bass0324/smart_touch_display/Smart_Display_Prototype.JPG

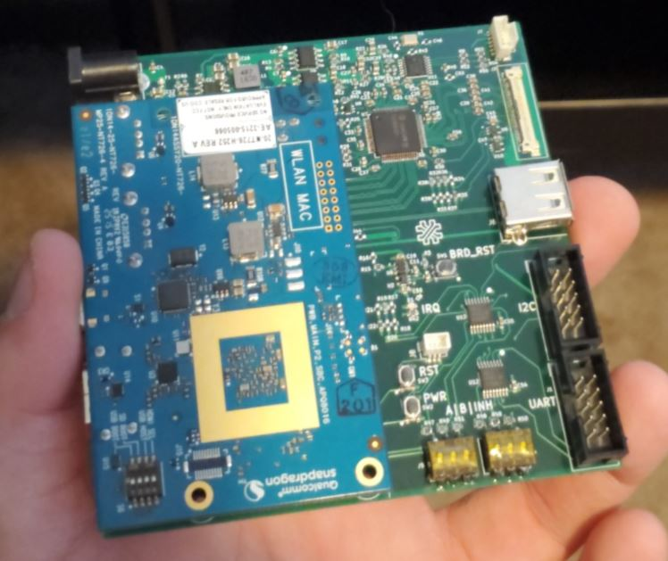
Smart_Display_Prototype.JPG
