bass0324/smart_touch_display/IMG_20190621_161926_01_01.jpg

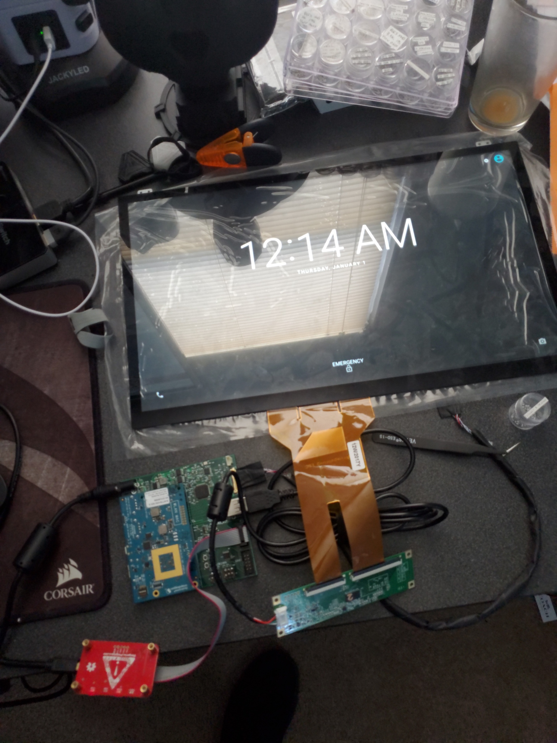
IMG_20190621_161926_01_01.jpg
