bass0324/smart_touch_display/Board Renders/Bad Phase/bottom.png

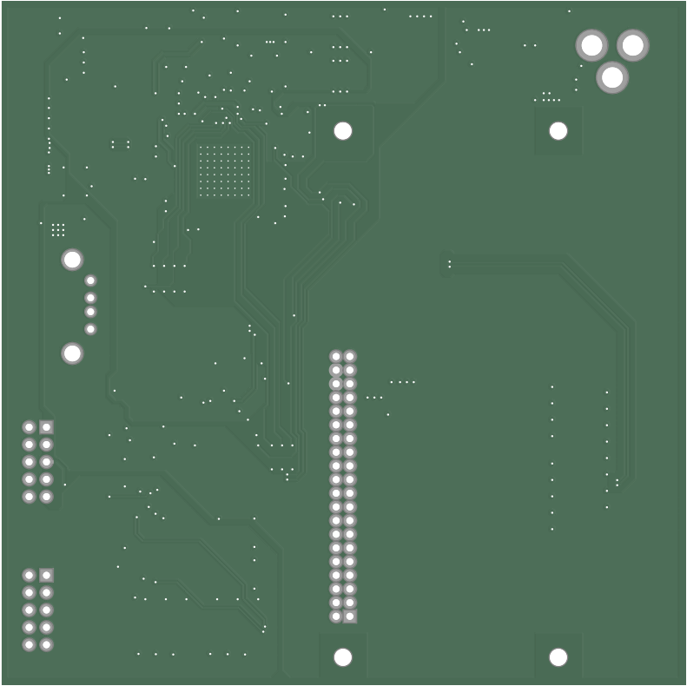
Board Renders/Bad Phase/bottom.png
