bass0324/smart_touch_display/Board Renders/Bad Phase/bottom_copper.png

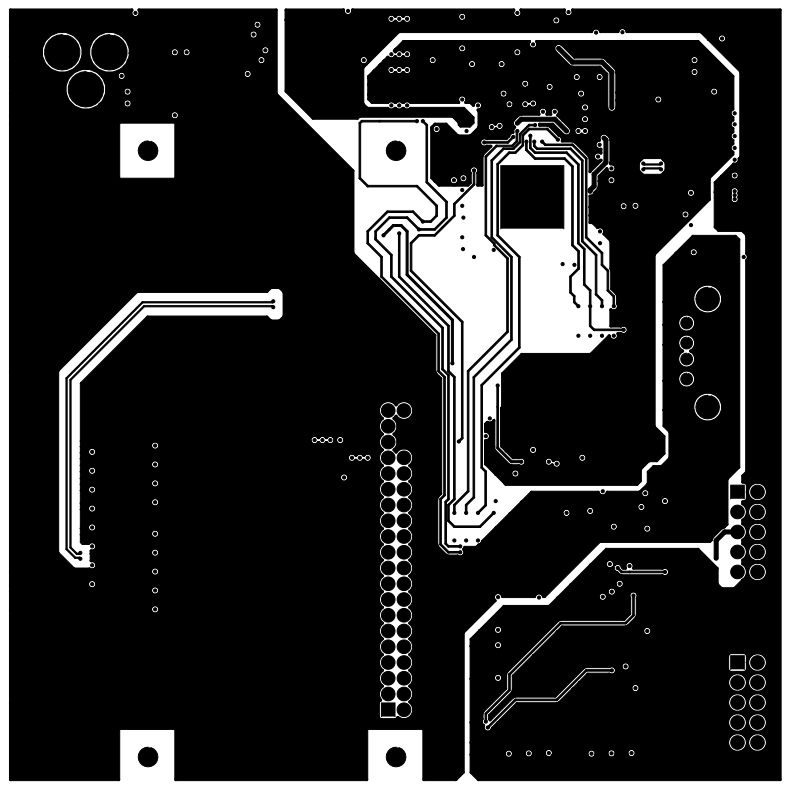
Board Renders/Bad Phase/bottom_copper.png
