bass0324/smart_touch_display/Board Renders/Bad Phase/mill.png

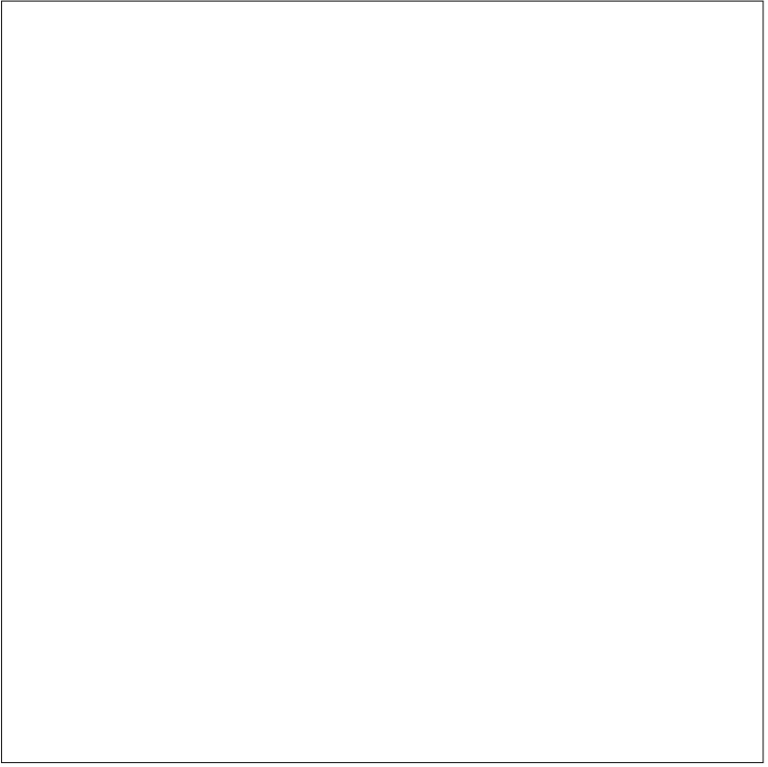
Board Renders/Bad Phase/mill.png
