bass0324/smart_touch_display/Board Renders/Bad Phase/top_silkscreen.png

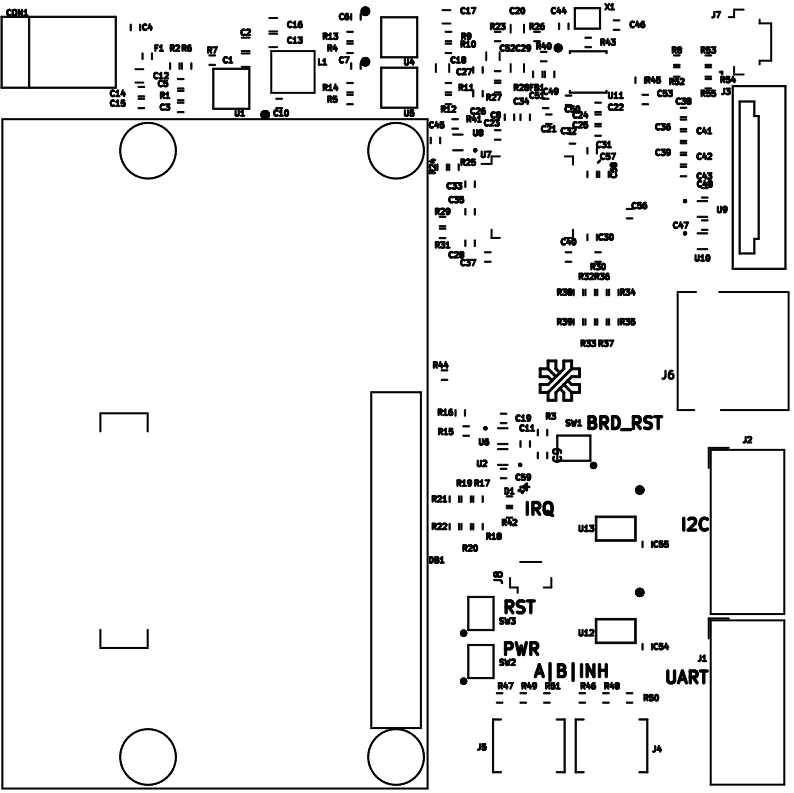
Board Renders/Bad Phase/top_silkscreen.png
