bass0324/smart_touch_display/IMG_20190530_161939_01_01.jpg

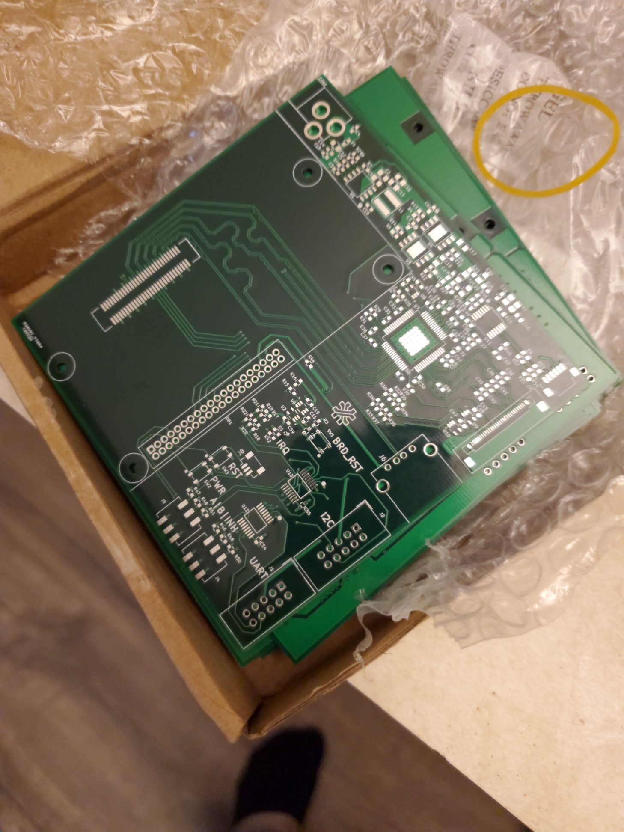
IMG_20190530_161939_01_01.jpg
