bass0324/smart_touch_display/IMG_20190613_172316_01_02.jpg

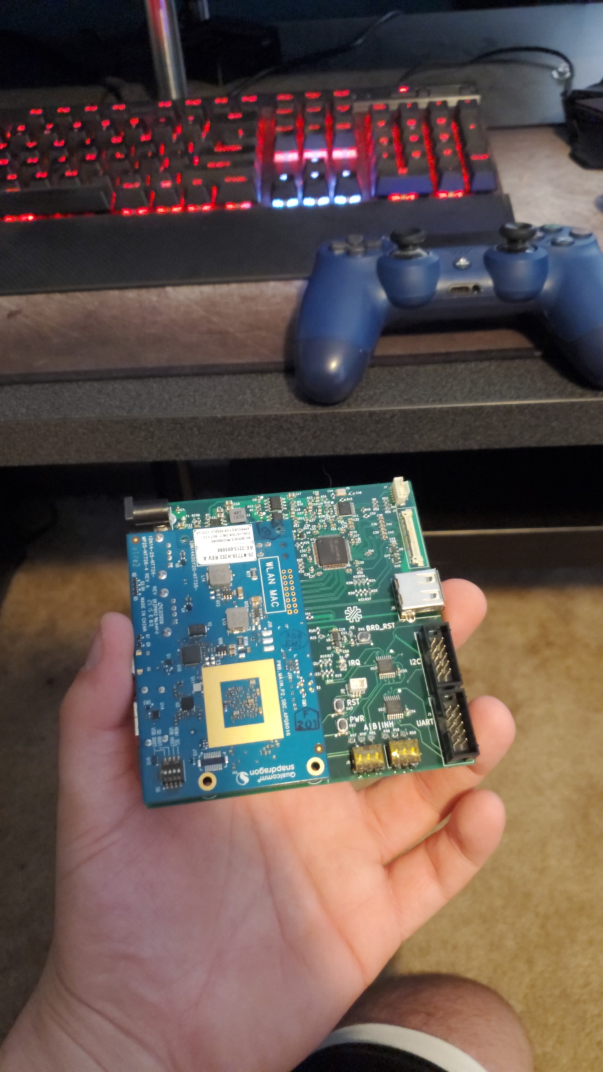
IMG_20190613_172316_01_02.jpg
