bass0324/smart_touch_display/Smart_Display_Block_Diagram.JPG

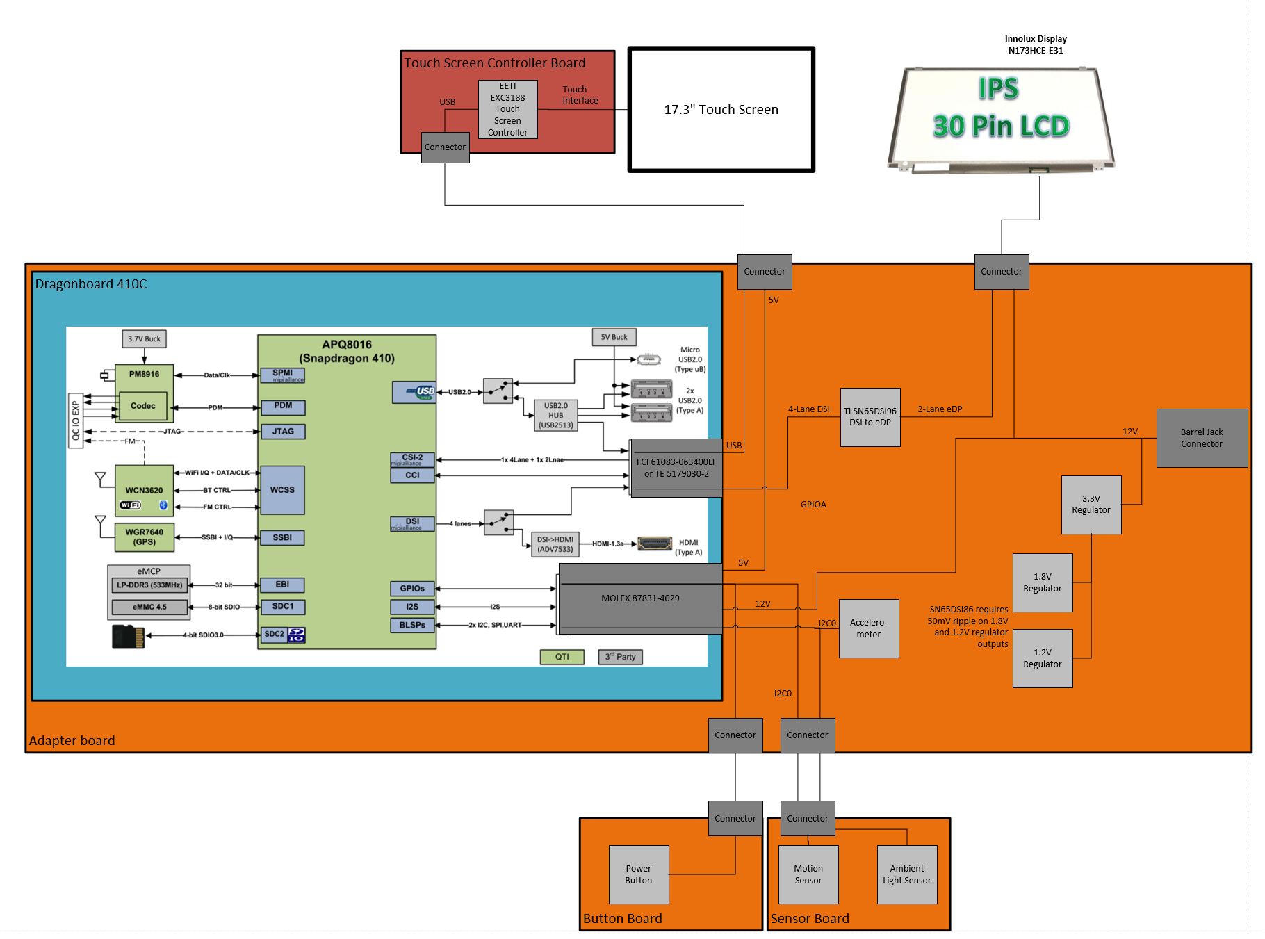
Smart_Display_Block_Diagram.JPG
