bass0324/smart_touch_display/Slate_Logic_Board.csv

Source: | C:/Users/basis/Dropbox/Projects/KiCAD/Slate_Logic_Board/Slate_Logic_Board.sch
Date: | 5/20/2019 9:18:26 PM
Tool: | Eeschema 4.0.7
Component Count: | 144
Ref | Value | Footprint | Datasheet | Manufacturer | Vendor
C1 | 10uF,0805,25V | Capacitors_SMD:C_0805
C2 | 10uF,0805,25V | Capacitors_SMD:C_0805
C3 | 0.1uF,0603,25V | bass:SMD_0603
C4 | 0.1uF,0603,25V | bass:SMD_0603
C5 | 3.3nF,0603,25V | bass:SMD_0603
C6 | 1uF,0603,25V | bass:SMD_0603
C7 | 1uF,0603,25V | bass:SMD_0603
C8 | 0.1uF,0603,25V | bass:SMD_0603
C9 | 0.1uF,0603,25V | bass:SMD_0603
C10 | 10nF,0603,25V | bass:SMD_0603
C11 | 220pF,0603,25V | bass:SMD_0603
C12 | 10uF,0805,25V | Capacitors_SMD:C_0805
C13 | 22uF,0805,25V | Capacitors_SMD:C_0805
C14 | 0.1uF,0603,25V | bass:SMD_0603
C15 | 0.1uF,0603,25V | bass:SMD_0603
C16 | 22uF,0805,25V | Capacitors_SMD:C_0805
C17 | 10uF,0805,25V | Capacitors_SMD:C_0805
C18 | 10uF,0805,25V | Capacitors_SMD:C_0805
C19 | 0.1uF,0603,25V | bass:SMD_0603
C20 | 10uF,0805,25V | Capacitors_SMD:C_0805
C21 | 0.1uF,0603,25V | bass:SMD_0603
C22 | 1uF,0603,25V | bass:SMD_0603
C23 | 0.1uF,0603,25V | bass:SMD_0603
C24 | 0.1uF,0603,25V | bass:SMD_0603
C25 | 0.1uF,0603,25V | bass:SMD_0603
C26 | 0.1uF,0603,25V | bass:SMD_0603
C27 | 0.1uF,0603,25V | bass:SMD_0603
C28 | 1uF,0603,25V | bass:SMD_0603
C29 | 10uF,0805,25V | Capacitors_SMD:C_0805
C30 | 0.1uF,0603,25V | bass:SMD_0603
C31 | 1uF,0603,25V | bass:SMD_0603
C32 | 0.1uF,0603,25V | bass:SMD_0603
C33 | 0.1uF,0603,25V | bass:SMD_0603
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
U8 | SN74LVC1G07DCK | bass:SOT23-5_65mm
U9 | SN74AUP1T08DCK | bass:SOT23-5_65mm
U10 | SN74AUP1T08DCK | bass:SOT23-5_65mm
U11 | CDCEL913PW | bass:TSSOP-14_4.4x5mm_Pitch0.65mm
U12 | SN74LV4052APW | bass:TSSOP16-0.65mm
U13 | SN74LV4052APW | bass:TSSOP16-0.65mm
X1 | CRYSTAL_27MHz | bass:4pin-SMD-OSC
