bass0324/smart_touch_display/Slate_Logic_Board.xlsx

Source: | C:/Users/basis/Dropbox/Projects/KiCAD/Slate_Logic_Board/Slate_Logic_Board.sch
Date: | 2019-05-20 21:18
Tool: | Eeschema 4.0.7
Component Count: | 144
Ref | Value | Footprint | Datasheet | Manufacturer | Vendor | Ordered? | Alternative | Placed?
R15 | 0,0402,1% | bass:SMD_0603 |  |  |  | In Stock |  | Y
R22 | 0,0402,1% | bass:SMD_0603 |  |  |  | In Stock |  | y
R23 | 0,0402,1% | bass:SMD_0603 |  |  |  | In Stock |  | y
R26 | 0,0402,1% | bass:SMD_0603 |  |  |  | In Stock |  | y
R27 | 0,0402,1% | bass:SMD_0603 |  |  |  | In Stock |  | y
R28 | 0,0402,1% | bass:SMD_0603 |  |  |  | In Stock |  | y
R29 | 0,0402,1% | bass:SMD_0603 |  |  |  | In Stock |  | y
R30 | 0,0402,1% | bass:SMD_0603 |  |  |  | In Stock |  | y
R31 | 0,0402,1% | bass:SMD_0603 |  |  |  | In Stock |  | y
R35 | 0,0402,1% | bass:SMD_0603 |  |  |  | In Stock |  | y, 4.7k
R4 | 0,0402,1% | bass:SMD_0603 |  |  |  | In Stock |  | y
R5 | 0,0402,1% | bass:SMD_0603 |  |  |  | In Stock |  | y
R52 | 0,0402,1% | bass:SMD_0603 |  |  |  | In Stock |  | y
R53 | 0,0402,1% | bass:SMD_0603 |  |  |  | In Stock |  | y
R54 | 0,0402,1% | bass:SMD_0603 |  |  |  | In Stock |  | y
R8 | 0,0402,1% | bass:SMD_0603 |  |  |  | In Stock |  | y
R18 | 0,0402,1%,DNI | bass:SMD_0603 |  |  |  | In Stock |  | DNI
R20 | 0,0402,1%,DNI | bass:SMD_0603 |  |  |  | In Stock |  | DNI
R25 | 0,0402,1%,DNI | bass:SMD_0603 |  |  |  | In Stock |  | DNI
R33 | 0,0402,1%,DNI | bass:SMD_0603 |  |  |  | In Stock |  | DNI
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
C18 | 10uF,0805,25V | Capacitors_SMD:C_0805 |  |  |  | Mouser |  | y
C2 | 10uF,0805,25V | Capacitors_SMD:C_0805 |  |  |  | Mouser |  | y
C20 | 10uF,0805,25V | Capacitors_SMD:C_0805 |  |  |  | Mouser |  | y
C29 | 10uF,0805,25V | Capacitors_SMD:C_0805 |  |  |  | Mouser |  | y
R9 | 12.4k,0402,1% | bass:SMD_0603 |  |  |  | Mouser |  | y
R45 | 18,0402,1% | bass:SMD_0603 |  |  |  | Mouser |  | y
R41 | 1k,0402,1% | bass:SMD_0603 |  |  |  | In Stock |  | y
R43 | 1M,0402,1%,DNI | bass:SMD_0603 |  |  |  | In Stock |  | DNI
C22 | 1uF,0603,25V | bass:SMD_0603 |  |  |  | In Stock |  | y
C28 | 1uF,0603,25V | bass:SMD_0603 |  |  |  | In Stock |  | y
C31 | 1uF,0603,25V | bass:SMD_0603 |  |  |  | In Stock |  | y
C6 | 1uF,0603,25V | bass:SMD_0603 |  |  |  | In Stock |  | y
C7 | 1uF,0603,25V | bass:SMD_0603 |  |  |  | In Stock |  | y
C11 | 220pF,0603,25V | bass:SMD_0603 |  |  |  | Mouser |  | y
C13 | 22uF,0805,25V | Capacitors_SMD:C_0805 |  |  |  | Mouser |  | y
C16 | 22uF,0805,25V | Capacitors_SMD:C_0805 |  |  |  | Mouser |  | y
C52 | 22uF,0805,25V | Capacitors_SMD:C_0805 |  |  |  | Mouser |  | y
R7 | 26.1k,0402,1% | bass:SMD_0603 |  |  |  | Mouser |  | y
C5 | 3.3nF,0603,25V | bass:SMD_0603 |  |  |  | In Stock |  | y
R42 | 330,0402,1% | bass:SMD_0603 |  |  |  | In Stock |  | y
R19 | 4.75k,0402,1% | bass:SMD_0603 |  |  |  | In Stock |  | y
R24 | 4.75k,0402,1% | bass:SMD_0603 |  |  |  | In Stock |  | y
R32 | 4.75k,0402,1% | bass:SMD_0603 |  |  |  | In Stock |  | y
R36 | 4.75k,0402,1% | bass:SMD_0603 |  |  |  | In Stock |  | y
R38 | 4.75k,0402,1% | bass:SMD_0603 |  |  |  | In Stock |  | y
R17 | 4.75k,0402,1%,DNI | bass:SMD_0603 |  |  |  | In Stock |  | DNI
R21 | 4.75k,0402,1%,DNI | bass:SMD_0603 |  |  |  | In Stock |  | DNI
R34 | 4.75k,0402,1%,DNI | bass:SMD_0603 |  |  |  | In Stock |  | DNI
L1 | 4.7uH | bass:L_Bourns_SRP5030CA | Bourns | SRP5030CA-4R7M |  | Mouser | SRP5030CA-2R2M | y
R11 | 4.99k,0402,1% | bass:SMD_0603 |  |  |  | Mouser |  | y
U1 | AP3512E | bass:SOIC-8-N | Diodes | AP3512EMTR-G1 |  | Digikey |  | y
U4 | AP7165_SO8 | bass:SOIC-8-N-AP7165 | Diodes | AP7165-SPG-13 |  | Mouser |  | y
U5 | AP7165_SO8 | bass:SOIC-8-N-AP7165 | Diodes | AP7165-SPG-13 |  | Mouser |  | y
CON1 | BARREL_JACK | bass:BARREL_JACK |  |  |  | In Stock
FB1 | BLM18EG221SN1D | bass:SMD_0603 | Murata | BLM18EG221SN1D |  | Mouser |  | y
SW1 | BUTTON_BASS | bass:CK_PTS810 | C&K | PTS810SJM250SMTR |  | Mouser |  | y
SW2 | BUTTON_BASS | bass:CK_PTS810 | C&K | PTS810SJM250SMTR |  | Mouser |  | y
SW3 | BUTTON_BASS | bass:CK_PTS810 | C&K | PTS810SJM250SMTR |  | Mouser |  | y
U11 | CDCEL913PW | bass:TSSOP-14_4.4x5mm_Pitch0.65mm | TI | CDCEL913PW |  | Sample |  | y
J8 | Conn_01x03 | Connectors_Molex:Molex_PicoClasp_501331-0307_1x03_P1.0mm_Vertical | Molex | 5013310307 |  | Mouser |  | y
J7 | Conn_01x06 | Connectors_Molex:Molex_PicoClasp_501331-0607_1x06_P1.0mm_Vertical | Molex | 5013310607 |  | Mouser |  | y
J3 | Conn_01x34 | bass:20455-030E | IPEX | 20455-030E |  | Ebay |  | y
J1 | CONN_02X05 | Connectors_IDC:IDC-Header_2x05_Pitch2.54mm_Straight | 3M | 30310-6002HB |  | Mouser
J2 | CONN_02X05 | Connectors_IDC:IDC-Header_2x05_Pitch2.54mm_Straight | 3M | 30310-6002HB |  | Mouser
X1 | CRYSTAL_27MHz | bass:4pin-SMD-OSC | Abracon | ABM8-27.000MHZ-10-1-U-T |  | Mouser |  | y
J4 | CT2193MST | bass:CT2193MST | CTS Electrocomponents | 219-3MST |  | Mouser |  | y
J5 | CT2193MST | bass:CT2193MST | CTS Electrocomponents | 219-3MST |  | Mouser |  | y
D1 | LED | bass:SMD_0603 |  |  |  | In Stock |  | y
U7 | SN65DSI86-Q1 | bass:HTQFP-64-1EP_10x10mm_Pitch0.5mm_ThermalPad_SN65DSIx6-Q1 | TI | SN65DSI86IPAPQ1 |  | Sample |  | y
U10 | SN74AUP1T08DCK | bass:SOT23-5_65mm | TI | SN74AUP1T08DCK |  | Sample |  | y
U2 | SN74AUP1T08DCK | bass:SOT23-5_65mm | TI | SN74AUP1T08DCK |  | Sample |  | y
U9 | SN74AUP1T08DCK | bass:SOT23-5_65mm | TI | SN74AUP1T08DCK |  | Sample |  | y
U12 | SN74LV4052APW | bass:TSSOP16-0.65mm | TI | SN74LV4052APW |  | Sample |  | y
U13 | SN74LV4052APW | bass:TSSOP16-0.65mm | TI | SN74LV4052APW |  | Sample |  | y
U8 | SN74LVC1G07DCK | bass:SOT23-5_65mm | TI | SN74LVC1G07DCK |  | Sample |  | y
U6 | TPS3808G18DBVT | bass:SOT23-6_65mm | TI | TPS3808G18DBVT |  | Sample |  | y
J6 | USB_A | Connectors:USB_A |  |  |  | In Stock
DB1 | Dragonboard | bass:96boards_baseboard | Moxel | 87831-4020 |  | Mouser
 |  |  | FCI | 61083-063400LF |  | Mouser |  | y
