bass0324/smart_touch_display/Board Renders/Bad Phase/bottom_soldermask.png

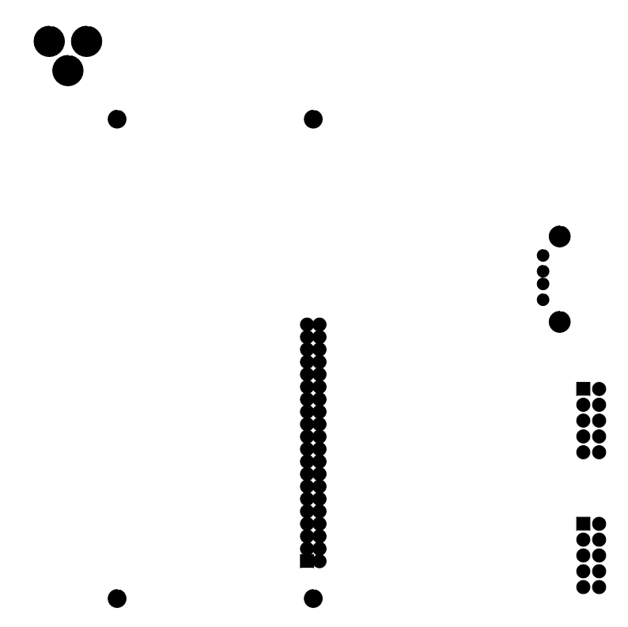
Board Renders/Bad Phase/bottom_soldermask.png
