bass0324/smart_touch_display/Board Renders/Bad Phase/top_soldermask.png

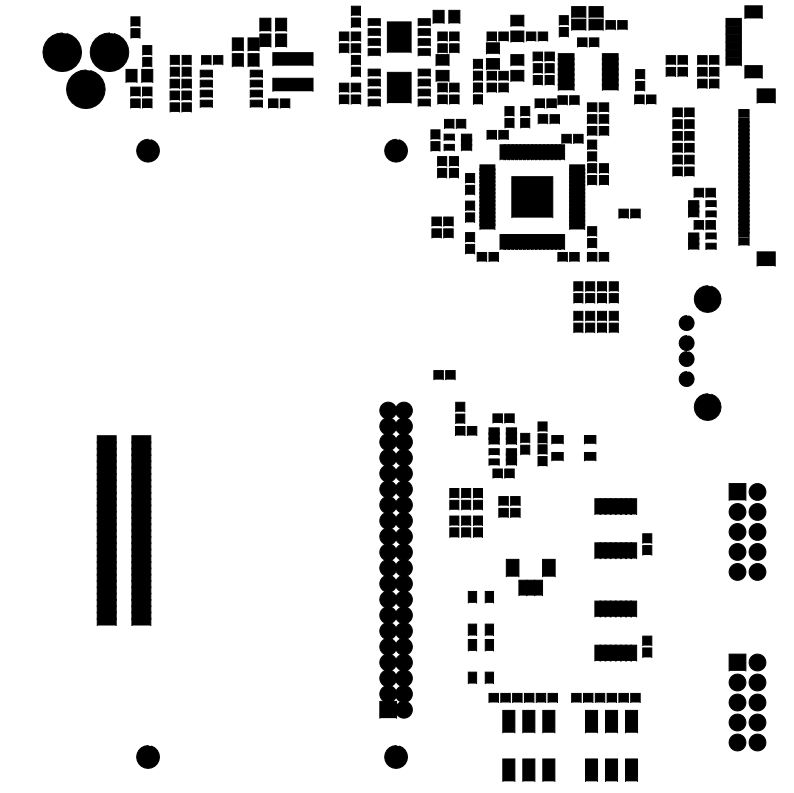
Board Renders/Bad Phase/top_soldermask.png
