bass0324/smart_touch_display/Slate_Logic_Board.kicad_pcb

## KiCad design Slate_Logic_Board.kicad_pcb (2019-06-22)

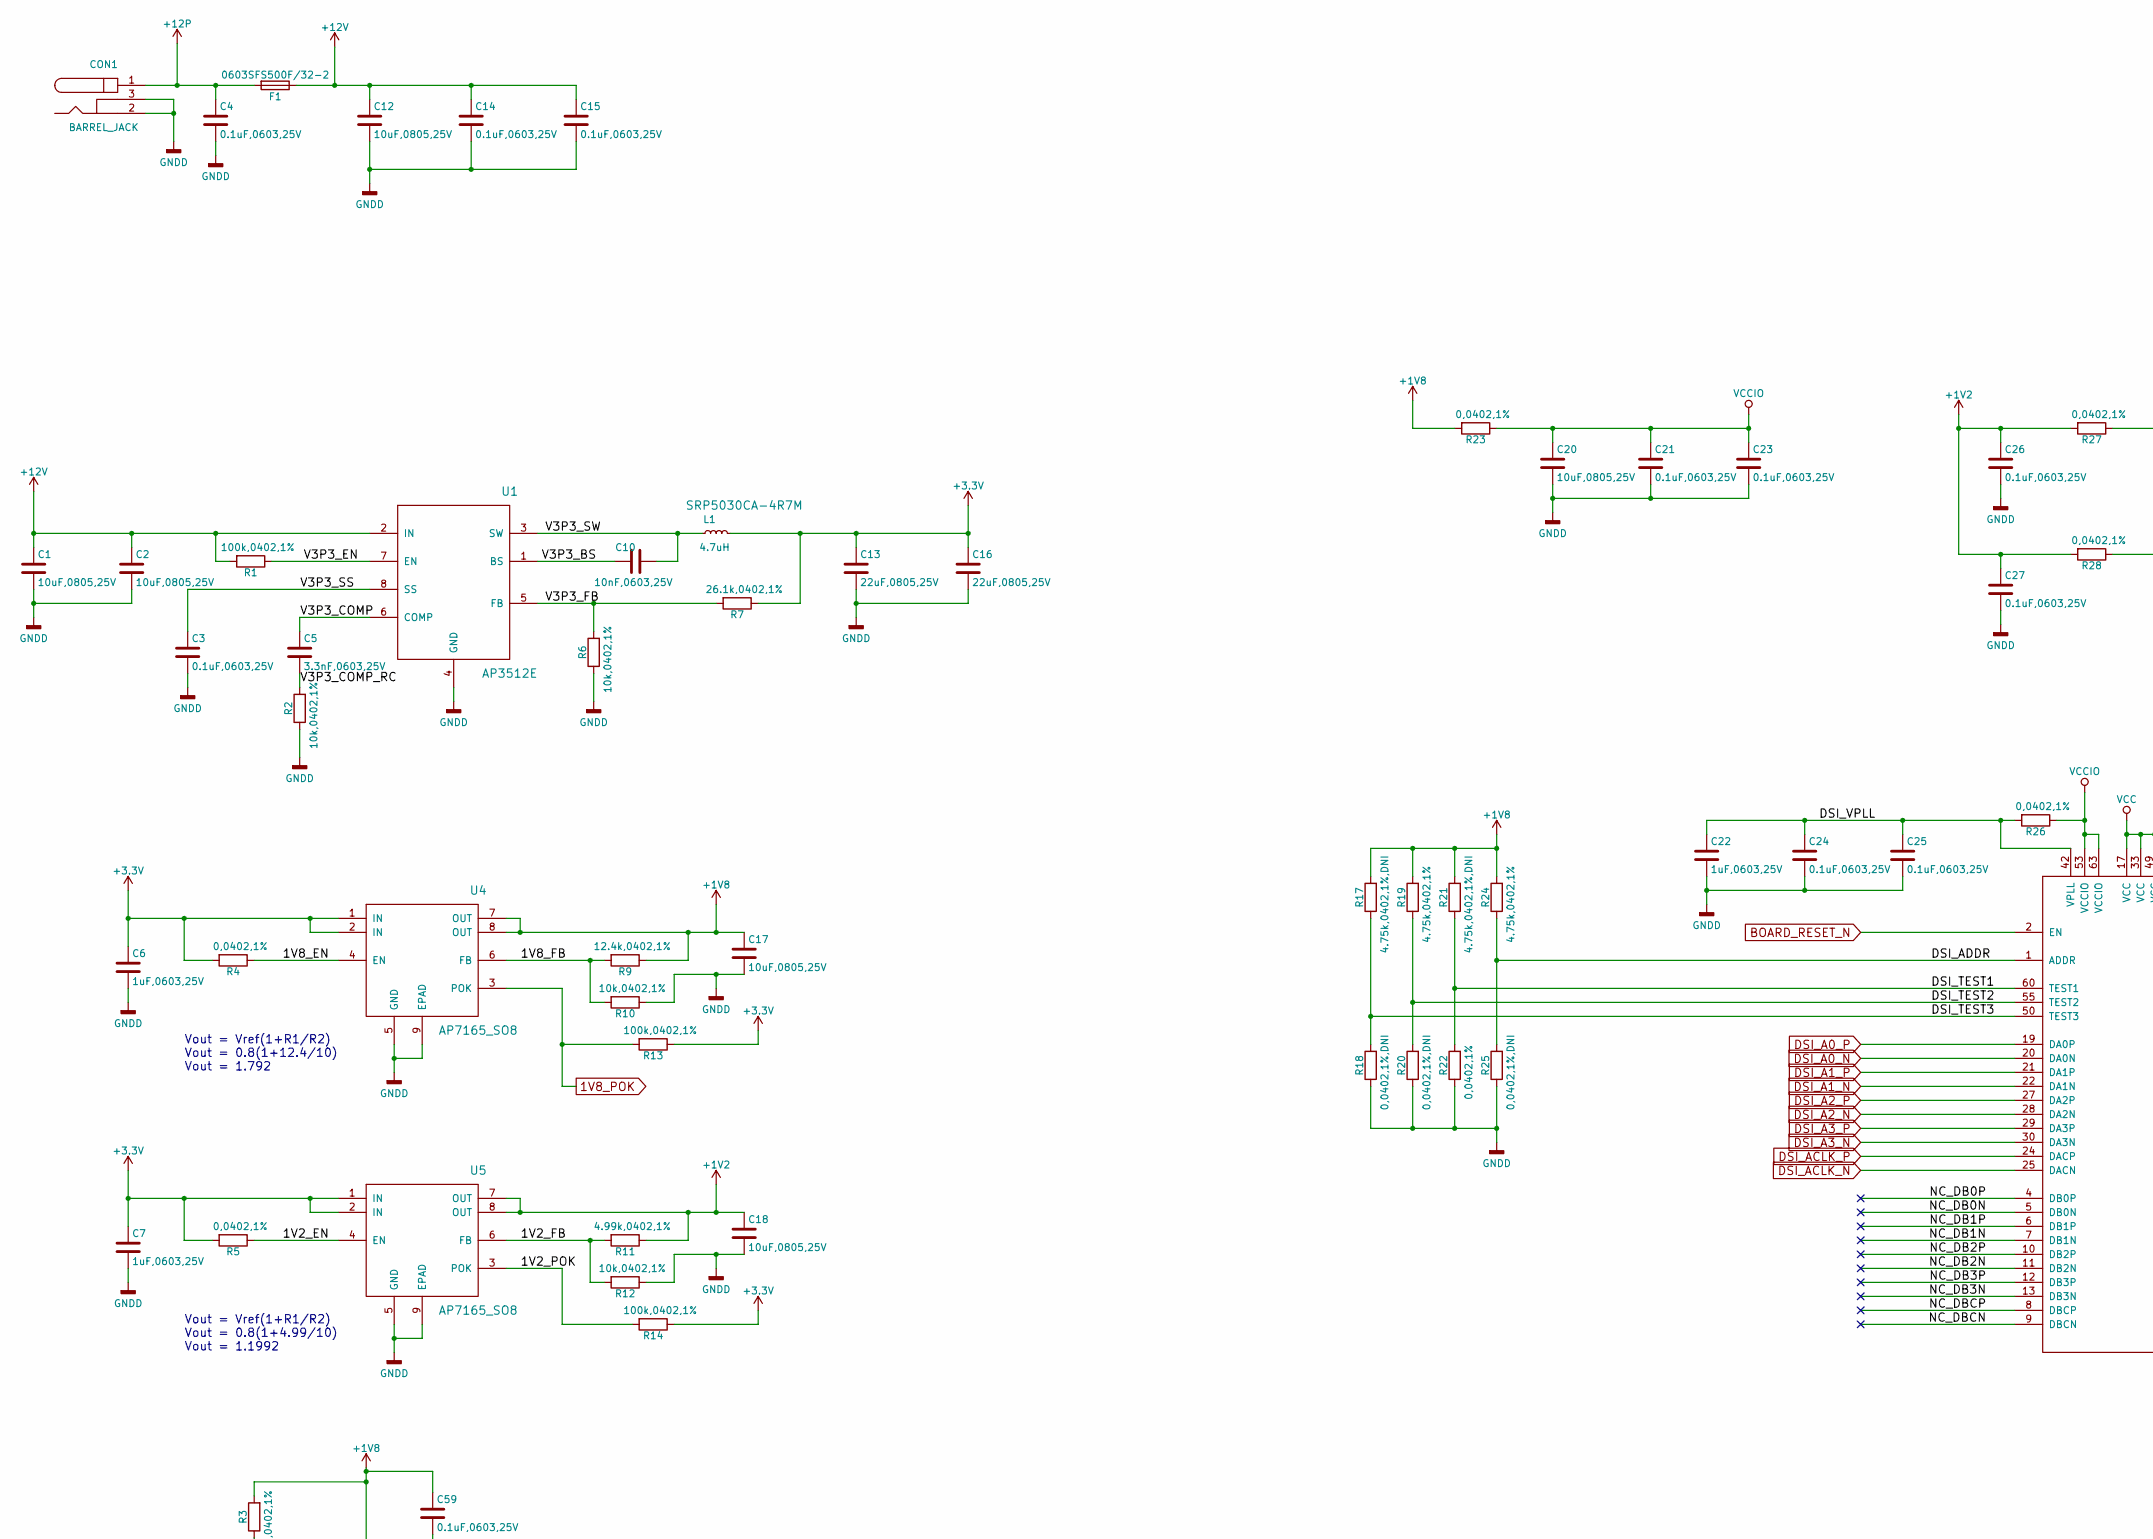
[picture p14: schematic Slate_Logic_Board.sch, TOC, part in row 1, column 1]

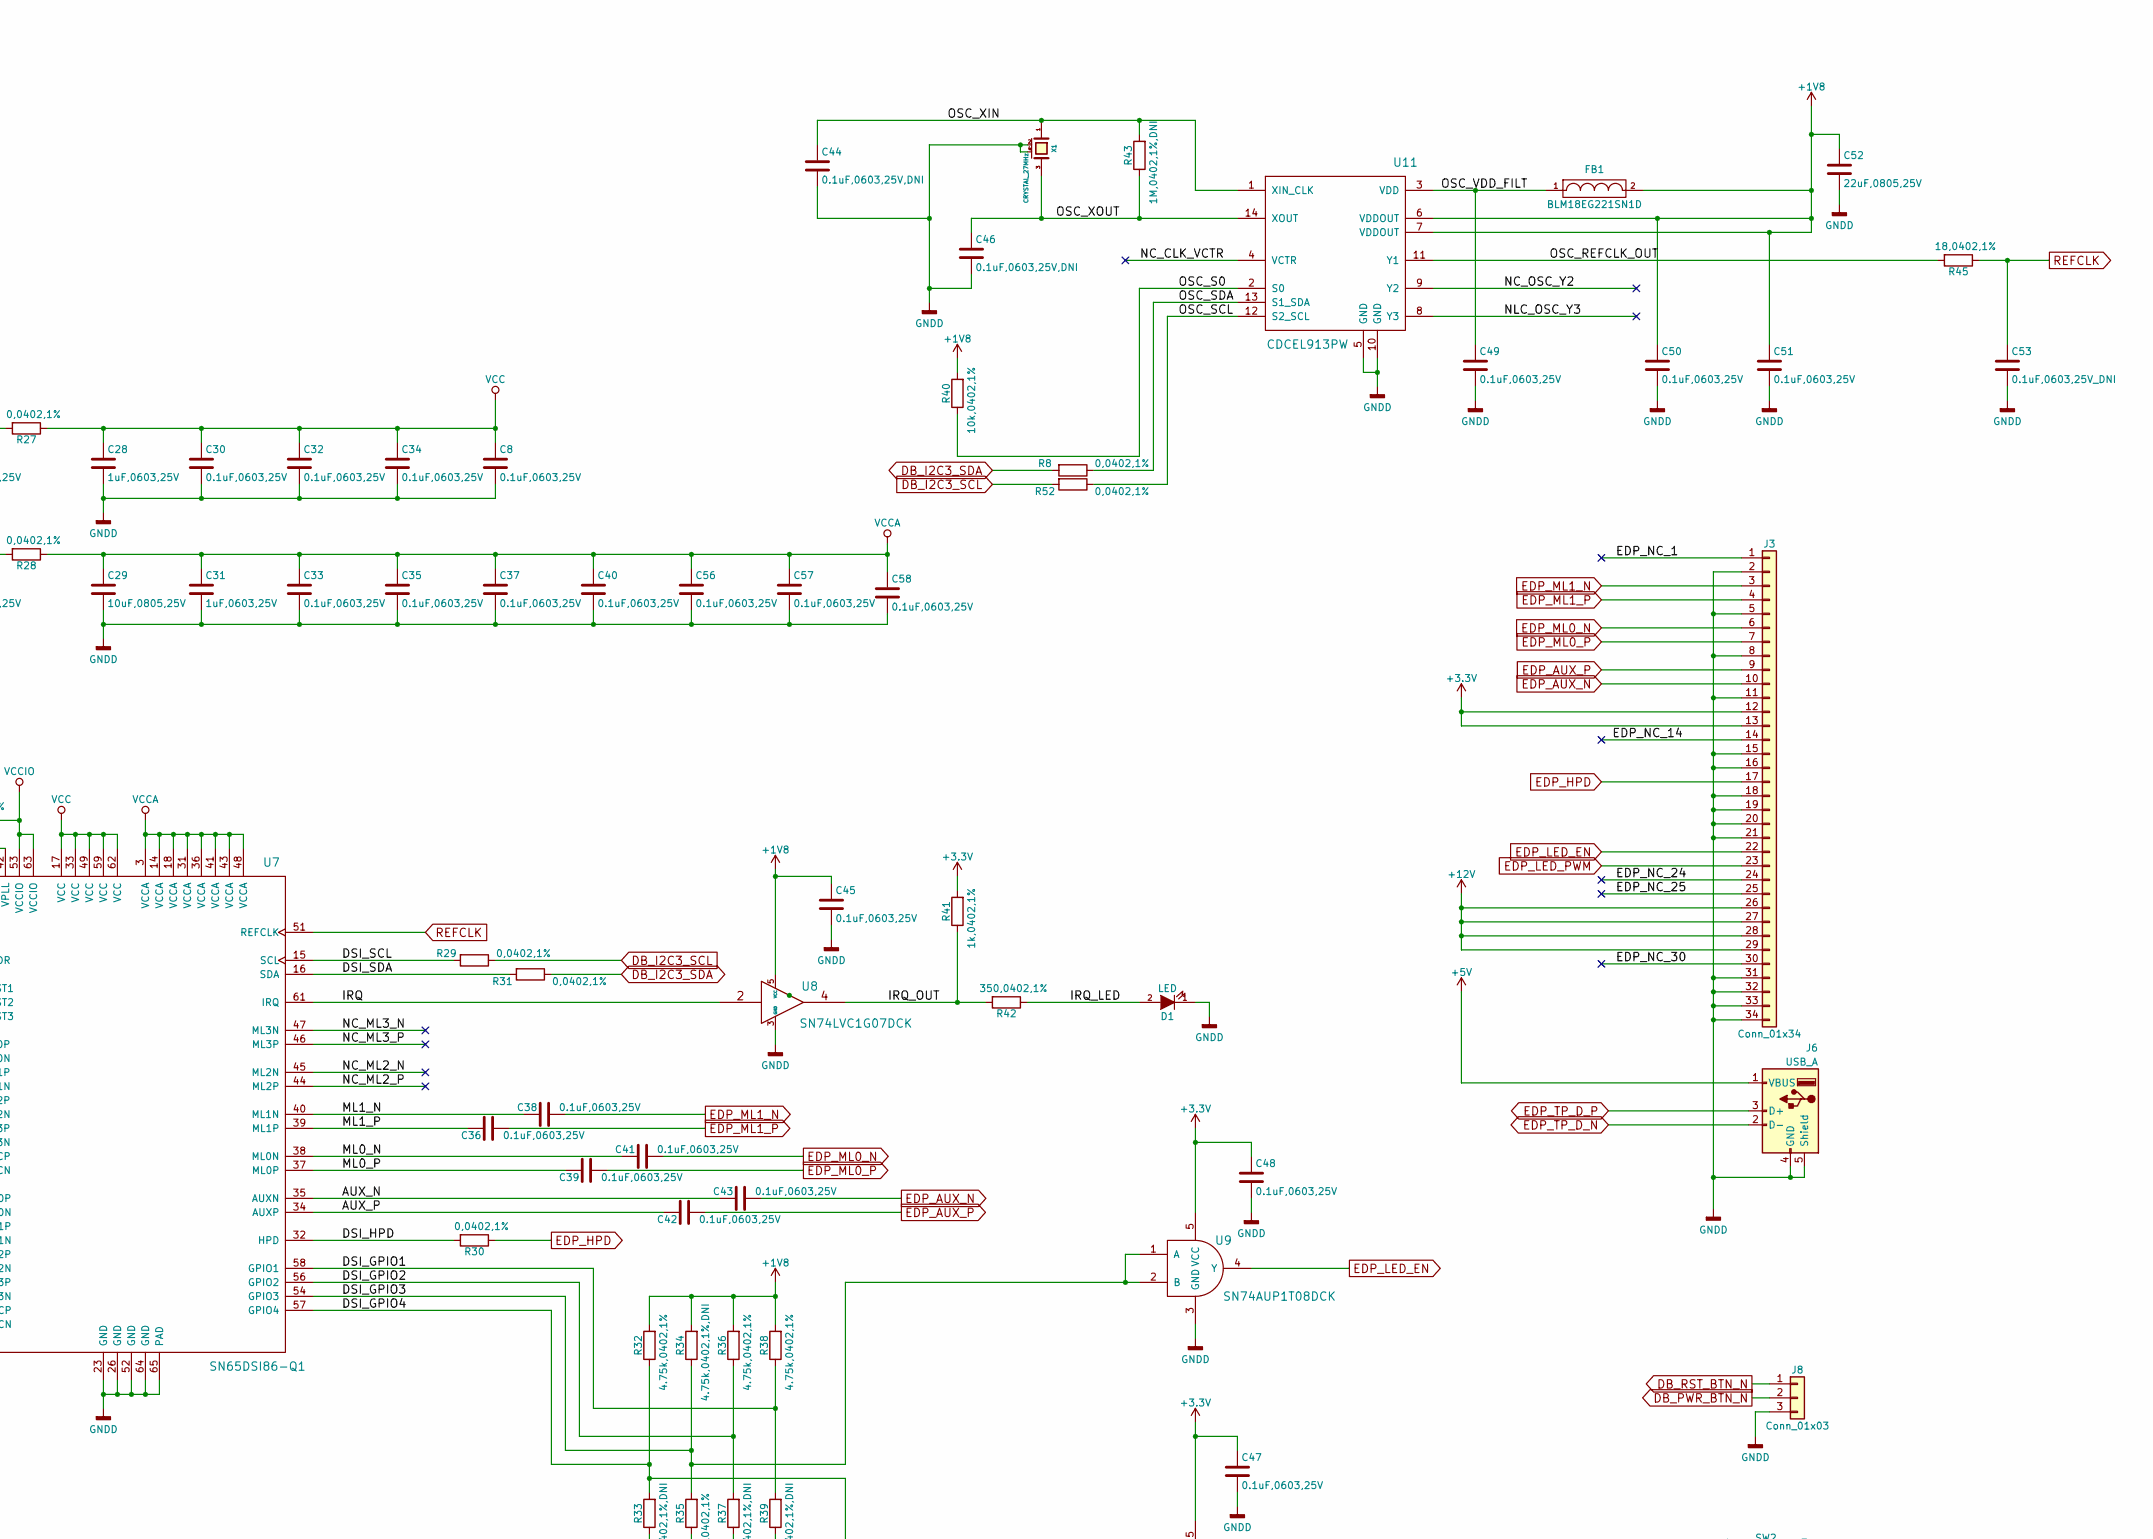
[picture p15: schematic Slate_Logic_Board.sch, TOC, part in row 1, column 2]

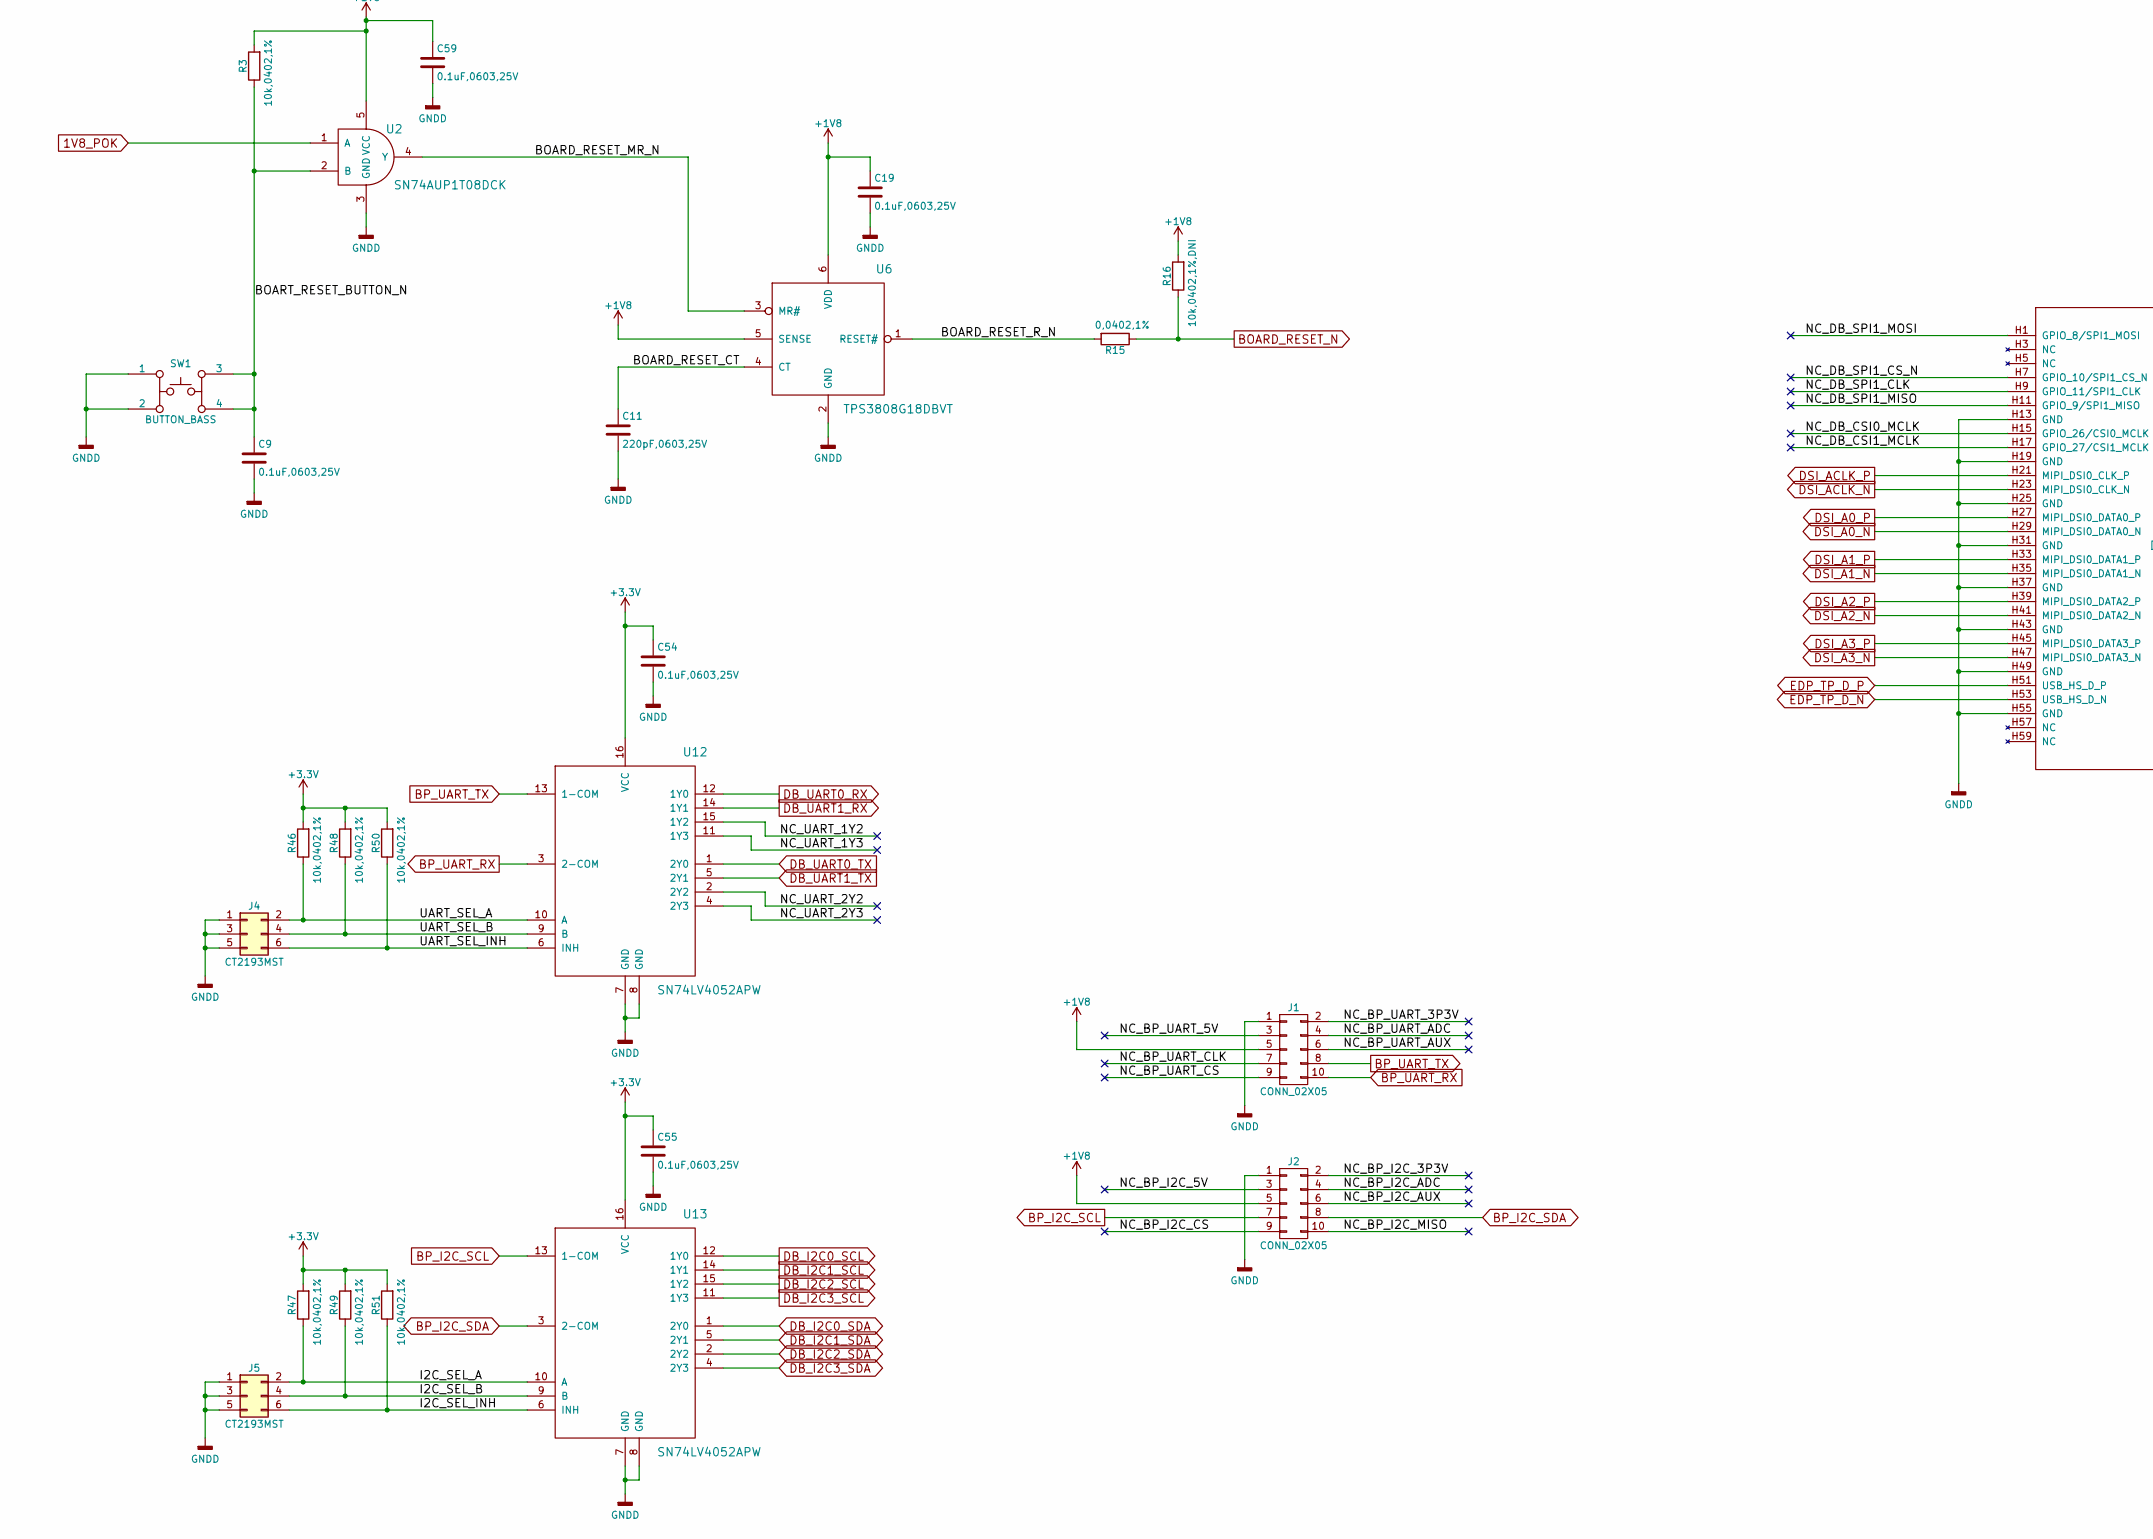
[picture p16: schematic Slate_Logic_Board.sch, TOC, part in row 2, column 1]

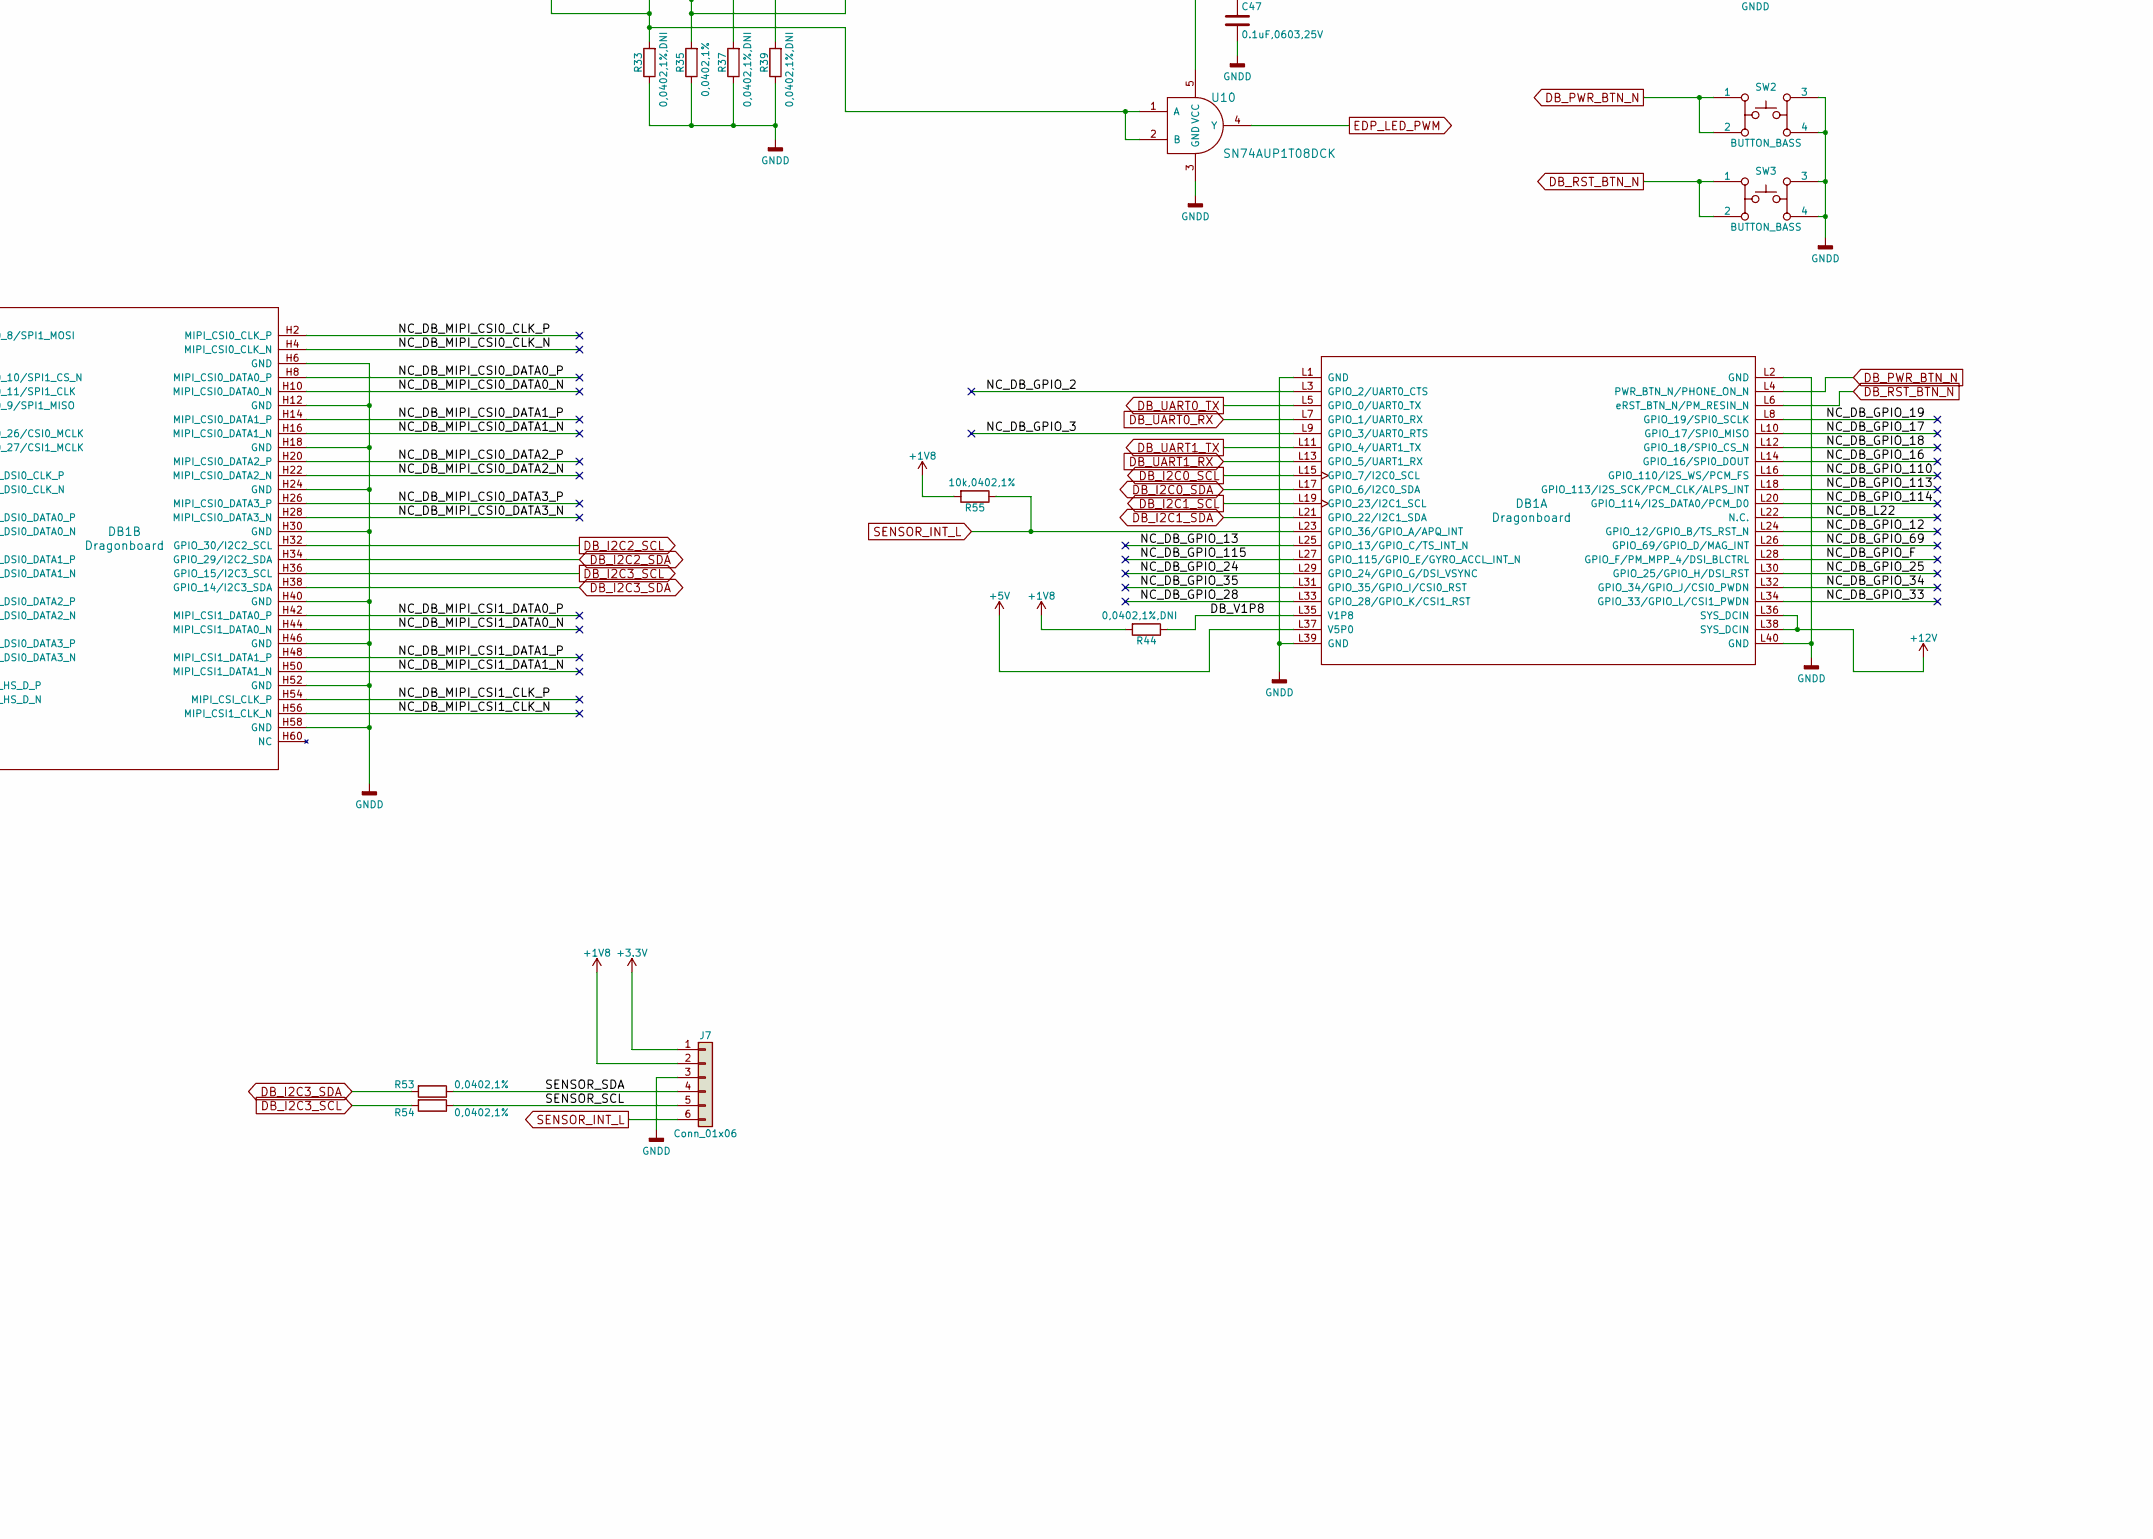
[picture p17: schematic Slate_Logic_Board.sch, TOC, part in row 2, column 2]

Parts:
C1, C2, C12, C17, C18, C20, C29: 10uF,0805,25V; C_0805
C3, C4, C8, C9, C14, C15, C19, C21, C23, C24, C25, C26, C27, C30, C32, C33, C34, C35, C36, C37, C38, C39, C40, C41, C42, C43, C45, C47, C48, C49, C50, C51, C54, C55, C56, C57, C58, C59: 0.1uF,0603,25V; SMD_0603
C5: 3.3nF,0603,25V; SMD_0603
C6, C7, C22, C28, C31: 1uF,0603,25V; SMD_0603
C10: 10nF,0603,25V; SMD_0603
C11: 220pF,0603,25V; SMD_0603
C13, C16, C52: 22uF,0805,25V; C_0805
C44, C46: 0.1uF,0603,25V,DNI; SMD_0603
C53: 0.1uF,0603,25V_DNI; SMD_0603
CON1: BARREL_JACK
D1: LED; SMD_0603
DB1: Dragonboard; 96boards_baseboard
F1: 0603SFS500F/32-2; SMD_0603
FB1: BLM18EG221SN1D; SMD_0603
J1, J2: CONN_02X05; IDC-Header_2x05_Pitch2.54mm_Straight
J3: Conn_01x34; 20455-030E
J4, J5: CT2193MST
J6: USB_A
J7: Conn_01x06; Molex_PicoClasp_501331-0607_1x06_P1.0mm_Vertical
J8: Conn_01x03; Molex_PicoClasp_501331-0307_1x03_P1.0mm_Vertical
L1: 4.7uH; L_Bourns_SRP5030CA
R1, R13, R14: 100k,0402,1%; SMD_0603
R2, R3, R6, R10, R12, R40, R46, R47, R48, R49, R50, R51, R55: 10k,0402,1%; SMD_0603
R4, R5, R8, R15, R22, R23, R26, R27, R28, R29, R30, R31, R35, R52, R53, R54: 0,0402,1%; SMD_0603
R7: 26.1k,0402,1%; SMD_0603
R9: 12.4k,0402,1%; SMD_0603
R11: 4.99k,0402,1%; SMD_0603
R16: 10k,0402,1%,DNI; SMD_0603
R17, R21, R34: 4.75k,0402,1%,DNI; SMD_0603
R18, R20, R25, R33, R37, R39, R44: 0,0402,1%,DNI; SMD_0603
R19, R24, R32, R36, R38: 4.75k,0402,1%; SMD_0603
R41: 1k,0402,1%; SMD_0603
R42: 350,0402,1%; SMD_0603
R43: 1M,0402,1%,DNI; SMD_0603
R45: 18,0402,1%; SMD_0603
SW1, SW2, SW3: BUTTON_BASS; CK_PTS810
U1: AP3512E; SOIC-8-N
U2, U9, U10: SN74AUP1T08DCK; SOT23-5_65mm
U4, U5: AP7165_SO8; SOIC-8-N-AP7165
U6: TPS3808G18DBVT; SOT23-6_65mm
U7: SN65DSI86-Q1; HTQFP-64-1EP_10x10mm_Pitch0.5mm_ThermalPad_SN65DSIx6-Q1
U8: SN74LVC1G07DCK; SOT23-5_65mm
U11: CDCEL913PW; TSSOP-14_4.4x5mm_Pitch0.65mm
U12, U13: SN74LV4052APW; TSSOP16-0.65mm
X1: CRYSTAL_27MHz; 4pin-SMD-OSC

Connections:
1V8_POK: R13.2, U2.1 (A), U4.3 (POK)
+1V2: C18.1, C26.1, C27.1, R11.1, R27.2, R28.2, U5.7 (OUT), U5.8 (OUT)
+1V8: C17.1, C19.1, C45.1, C50.1, C51.1, C52.1, C59.1, FB1.2, J1.5, J2.5, J7.2, R3.2, R9.1, R16.2, R17.2, R19.2, R21.2, R23.2, R24.2, R32.2, R34.2, R36.2, R38.2, R40.2, R44.2, R55.2, U2.5 (VCC), U4.7 (OUT), U4.8 (OUT), U6.5 (SENSE), U6.6 (VDD), U8.5 (VCC), U11.6 (VDDOUT), U11.7 (VDDOUT)
+3V3: C6.1, C7.1, C13.1, C16.1, C47.1, C48.1, C54.1, C55.1, J3.12, J3.13, J7.1, L1.2, R4.2, R5.2, R7.1, R13.1, R14.1, R41.2, R46.2, R47.2, R48.2, R49.2, R50.2, R51.2, U4.1 (IN), U4.2 (IN), U5.1 (IN), U5.2 (IN), U9.5 (VCC), U10.5 (VCC), U12.16 (VCC), U13.16 (VCC)
+5V: DB1.L37 (V5P0), J6.1 (VBUS)
+12P: C4.1, CON1.1, F1.2
+12V: C1.1, C2.1, C12.1, C14.1, C15.1, DB1.L36 (SYS_DCIN), DB1.L38 (SYS_DCIN), F1.1, J3.26, J3.27, J3.28, J3.29, R1.2, U1.2 (IN)
/1V2_EN: R5.1, U5.4 (EN)
/1V2_FB: R11.2, R12.2, U5.6 (FB)
/1V2_POK: R14.2, U5.3 (POK)
/1V8_EN: R4.1, U4.4 (EN)
/1V8_FB: R9.2, R10.2, U4.6 (FB)
/AUX_N: C43.2, U7.35 (AUXN)
/AUX_P: C42.2, U7.34 (AUXP)
/BOARD_RESET_CT: C11.1, U6.4 (CT)
/BOARD_RESET_MR_N: U2.4 (Y), U6.3 (MR#)
/BOARD_RESET_R_N: R15.2, U6.1 (RESET#)
/BOART_RESET_BUTTON_N: C9.1, R3.1, SW1.3, SW1.4, U2.2 (B)
/DB_V1P8: DB1.L35 (V1P8), R44.1
/DSI_ADDR: R24.1, R25.2, U7.1 (ADDR)
/DSI_GPIO1: R38.1, R39.2, U7.58 (GPIO1)
/DSI_GPIO2: R36.1, R37.2, U7.56 (GPIO2)
/DSI_GPIO3: R34.1, R35.2, U7.54 (GPIO3), U9.1 (A), U9.2 (B)
/DSI_GPIO4: R32.1, R33.2, U7.57 (GPIO4), U10.1 (A), U10.2 (B)
/DSI_HPD: R30.2, U7.32 (HPD)
/DSI_SCL: R29.2, U7.15 (SCL)
/DSI_SDA: R31.2, U7.16 (SDA)
/DSI_TEST1: R21.1, R22.2, U7.60 (TEST1)
/DSI_TEST2: R19.1, R20.2, U7.55 (TEST2)
/DSI_TEST3: R17.1, R18.2, U7.50 (TEST3)
/DSI_VPLL: C22.1, C24.1, C25.1, R26.2, U7.42 (VPLL)
/EDP_NC_1: J3.1
/EDP_NC_14: J3.14
/EDP_NC_24: J3.24
/EDP_NC_25: J3.25
/EDP_NC_30: J3.30
/I2C_SEL_A: J5.2, R47.1, U13.10 (A)
/I2C_SEL_B: J5.4, R49.1, U13.9 (B)
/I2C_SEL_INH: J5.6, R51.1, U13.6 (INH)
/IRQ: U7.61 (IRQ), U8.2
/IRQ_LED: D1.2 (A), R42.1
/IRQ_OUT: R41.1, R42.2, U8.4
/ML0_N: C41.2, U7.38 (ML0N)
/ML0_P: C39.2, U7.37 (ML0P)
/ML1_N: C38.2, U7.40 (ML1N)
/ML1_P: C36.2, U7.39 (ML1P)
/NC_BP_I2C_3P3V: J2.2
/NC_BP_I2C_5V: J2.3
/NC_BP_I2C_ADC: J2.4
/NC_BP_I2C_AUX: J2.6
/NC_BP_I2C_CS: J2.9
/NC_BP_I2C_MISO: J2.10
/NC_BP_UART_3P3V: J1.2
/NC_BP_UART_5V: J1.3
/NC_BP_UART_ADC: J1.4
/NC_BP_UART_AUX: J1.6
/NC_BP_UART_CLK: J1.7
/NC_BP_UART_CS: J1.9
/NC_CLK_VCTR: U11.4 (VCTR)
/NC_DB0N: U7.5 (DB0N)
/NC_DB0P: U7.4 (DB0P)
/NC_DB1N: U7.7 (DB1N)
/NC_DB1P: U7.6 (DB1P)
/NC_DB2N: U7.11 (DB2N)
/NC_DB2P: U7.10 (DB2P)
/NC_DB3N: U7.13 (DB3N)
/NC_DB3P: U7.12 (DB3P)
/NC_DBCN: U7.9 (DBCN)
/NC_DBCP: U7.8 (DBCP)
/NC_DB_CSI0_MCLK: DB1.H15 (GPIO_26/CSI0_MCLK)
/NC_DB_CSI1_MCLK: DB1.H17 (GPIO_27/CSI1_MCLK)
/NC_DB_GPIO_2: DB1.L3 (GPIO_2/UART0_CTS)
/NC_DB_GPIO_3: DB1.L9 (GPIO_3/UART0_RTS)
/NC_DB_GPIO_12: DB1.L24 (GPIO_12/GPIO_B/TS_RST_N)
/NC_DB_GPIO_13: DB1.L25 (GPIO_13/GPIO_C/TS_INT_N)
/NC_DB_GPIO_16: DB1.L14 (GPIO_16/SPI0_DOUT)
/NC_DB_GPIO_17: DB1.L10 (GPIO_17/SPI0_MISO)
/NC_DB_GPIO_18: DB1.L12 (GPIO_18/SPI0_CS_N)
/NC_DB_GPIO_19: DB1.L8 (GPIO_19/SPI0_SCLK)
/NC_DB_GPIO_24: DB1.L29 (GPIO_24/GPIO_G/DSI_VSYNC)
/NC_DB_GPIO_25: DB1.L30 (GPIO_25/GPIO_H/DSI_RST)
/NC_DB_GPIO_28: DB1.L33 (GPIO_28/GPIO_K/CSI1_RST)
/NC_DB_GPIO_33: DB1.L34 (GPIO_33/GPIO_L/CSI1_PWDN)
/NC_DB_GPIO_34: DB1.L32 (GPIO_34/GPIO_J/CSI0_PWDN)
/NC_DB_GPIO_35: DB1.L31 (GPIO_35/GPIO_I/CSI0_RST)
/NC_DB_GPIO_69: DB1.L26 (GPIO_69/GPIO_D/MAG_INT)
/NC_DB_GPIO_110: DB1.L16 (GPIO_110/I2S_WS/PCM_FS)
/NC_DB_GPIO_113: DB1.L18 (GPIO_113/I2S_SCK/PCM_CLK/ALPS_INT)
/NC_DB_GPIO_114: DB1.L20 (GPIO_114/I2S_DATA0/PCM_D0)
/NC_DB_GPIO_115: DB1.L27 (GPIO_115/GPIO_E/GYRO_ACCL_INT_N)
/NC_DB_GPIO_F: DB1.L28 (GPIO_F/PM_MPP_4/DSI_BLCTRL)
/NC_DB_L22: DB1.L22 (N.C.)
/NC_DB_MIPI_CSI0_CLK_N: DB1.H4 (MIPI_CSI0_CLK_N)
/NC_DB_MIPI_CSI0_CLK_P: DB1.H2 (MIPI_CSI0_CLK_P)
/NC_DB_MIPI_CSI0_DATA0_N: DB1.H10 (MIPI_CSI0_DATA0_N)
/NC_DB_MIPI_CSI0_DATA0_P: DB1.H8 (MIPI_CSI0_DATA0_P)
/NC_DB_MIPI_CSI0_DATA1_N: DB1.H16 (MIPI_CSI0_DATA1_N)
/NC_DB_MIPI_CSI0_DATA1_P: DB1.H14 (MIPI_CSI0_DATA1_P)
/NC_DB_MIPI_CSI0_DATA2_N: DB1.H22 (MIPI_CSI0_DATA2_N)
/NC_DB_MIPI_CSI0_DATA2_P: DB1.H20 (MIPI_CSI0_DATA2_P)
/NC_DB_MIPI_CSI0_DATA3_N: DB1.H28 (MIPI_CSI0_DATA3_N)
/NC_DB_MIPI_CSI0_DATA3_P: DB1.H26 (MIPI_CSI0_DATA3_P)
/NC_DB_MIPI_CSI1_CLK_N: DB1.H56 (MIPI_CSI1_CLK_N)
/NC_DB_MIPI_CSI1_CLK_P: DB1.H54 (MIPI_CSI_CLK_P)
/NC_DB_MIPI_CSI1_DATA0_N: DB1.H44 (MIPI_CSI1_DATA0_N)
/NC_DB_MIPI_CSI1_DATA0_P: DB1.H42 (MIPI_CSI1_DATA0_P)
/NC_DB_MIPI_CSI1_DATA1_N: DB1.H50 (MIPI_CSI1_DATA1_N)
/NC_DB_MIPI_CSI1_DATA1_P: DB1.H48 (MIPI_CSI1_DATA1_P)
/NC_DB_SPI1_CLK: DB1.H9 (GPIO_11/SPI1_CLK)
/NC_DB_SPI1_CS_N: DB1.H7 (GPIO_10/SPI1_CS_N)
/NC_DB_SPI1_MISO: DB1.H11 (GPIO_9/SPI1_MISO)
/NC_DB_SPI1_MOSI: DB1.H1 (GPIO_8/SPI1_MOSI)
/NC_ML2_N: U7.45 (ML2N)
/NC_ML2_P: U7.44 (ML2P)
/NC_ML3_N: U7.47 (ML3N)
/NC_ML3_P: U7.46 (ML3P)
/NC_OSC_Y2: U11.9 (Y2)
/NC_UART_1Y2: U12.15 (1Y2)
/NC_UART_1Y3: U12.11 (1Y3)
/NC_UART_2Y2: U12.2 (2Y2)
/NC_UART_2Y3: U12.4 (2Y3)
/NLC_OSC_Y3: U11.8 (Y3)
/OSC_REFCLK_OUT: R45.2, U11.11 (Y1)
/OSC_S0: R40.1, U11.2 (S0)
/OSC_SCL: R52.1, U11.12 (S2_SCL)
/OSC_SDA: R8.1, U11.13 (S1_SDA)
/OSC_VDD_FILT: C49.1, FB1.1, U11.3 (VDD)
/OSC_XIN: C44.1, R43.2, U11.1 (XIN_CLK), X1.1
/OSC_XOUT: C46.1, R43.1, U11.14 (XOUT), X1.3
/SENSOR_SCL: J7.5, R54.1
/SENSOR_SDA: J7.4, R53.1
/UART_SEL_A: J4.2, R46.1, U12.10 (A)
/UART_SEL_B: J4.4, R48.1, U12.9 (B)
/UART_SEL_INH: J4.6, R50.1, U12.6 (INH)
/V3P3_BS: C10.2, U1.1 (BS)
/V3P3_COMP: C5.1, U1.6 (COMP)
/V3P3_COMP_RC: C5.2, R2.2
/V3P3_EN: R1.1, U1.7 (EN)
/V3P3_FB: R6.2, R7.2, U1.5 (FB)
/V3P3_SS: C3.1, U1.8 (SS)
/V3P3_SW: C10.1, L1.1, U1.3 (SW)
BOARD_RESET_N: R15.1, R16.1, U7.2 (EN)
BP_I2C_SCL: J2.7, U13.13 (1-COM)
BP_I2C_SDA: J2.8, U13.3 (2-COM)
BP_UART_RX: J1.10, U12.3 (2-COM)
BP_UART_TX: J1.8, U12.13 (1-COM)
DB_I2C0_SCL: DB1.L15 (GPIO_7/I2C0_SCL), U13.12 (1Y0)
DB_I2C0_SDA: DB1.L17 (GPIO_6/I2C0_SDA), U13.1 (2Y0)
DB_I2C1_SCL: DB1.L19 (GPIO_23/I2C1_SCL), U13.14 (1Y1)
DB_I2C1_SDA: DB1.L21 (GPIO_22/I2C1_SDA), U13.5 (2Y1)
DB_I2C2_SCL: DB1.H32 (GPIO_30/I2C2_SCL), U13.15 (1Y2)
DB_I2C2_SDA: DB1.H34 (GPIO_29/I2C2_SDA), U13.2 (2Y2)
DB_I2C3_SCL: DB1.H36 (GPIO_15/I2C3_SCL), R29.1, R52.2, R54.2, U13.11 (1Y3)
DB_I2C3_SDA: DB1.H38 (GPIO_14/I2C3_SDA), R8.2, R31.1, R53.2, U13.4 (2Y3)
DB_PWR_BTN_N: DB1.L4 (PWR_BTN_N/PHONE_ON_N), J8.2, SW2.1, SW2.2
DB_RST_BTN_N: DB1.L6 (eRST_BTN_N/PM_RESIN_N), J8.1, SW3.1, SW3.2
DB_UART0_RX: DB1.L7 (GPIO_1/UART0_RX), U12.12 (1Y0)
DB_UART0_TX: DB1.L5 (GPIO_0/UART0_TX), U12.1 (2Y0)
DB_UART1_RX: DB1.L13 (GPIO_5/UART1_RX), U12.14 (1Y1)
DB_UART1_TX: DB1.L11 (GPIO_4/UART1_TX), U12.5 (2Y1)
DSI_A0_N: DB1.H29 (MIPI_DSI0_DATA0_N), U7.20 (DA0N)
DSI_A0_P: DB1.H27 (MIPI_DSI0_DATA0_P), U7.19 (DA0P)
DSI_A1_N: DB1.H35 (MIPI_DSI0_DATA1_N), U7.22 (DA1N)
DSI_A1_P: DB1.H33 (MIPI_DSI0_DATA1_P), U7.21 (DA1P)
DSI_A2_N: DB1.H41 (MIPI_DSI0_DATA2_N), U7.28 (DA2N)
DSI_A2_P: DB1.H39 (MIPI_DSI0_DATA2_P), U7.27 (DA2P)
DSI_A3_N: DB1.H47 (MIPI_DSI0_DATA3_N), U7.30 (DA3N)
DSI_A3_P: DB1.H45 (MIPI_DSI0_DATA3_P), U7.29 (DA3P)
DSI_ACLK_N: DB1.H23 (MIPI_DSI0_CLK_N), U7.25 (DACN)
DSI_ACLK_P: DB1.H21 (MIPI_DSI0_CLK_P), U7.24 (DACP)
EDP_AUX_N: C43.1, J3.10
EDP_AUX_P: C42.1, J3.9
EDP_HPD: J3.17, R30.1
EDP_LED_EN: J3.22, U9.4 (Y)
EDP_LED_PWM: J3.23, U10.4 (Y)
EDP_ML0_N: C41.1, J3.6
EDP_ML0_P: C39.1, J3.7
EDP_ML1_N: C38.1, J3.3
EDP_ML1_P: C36.1, J3.4
EDP_TP_D_N: DB1.H53 (USB_HS_D_N), J6.2 (D-)
EDP_TP_D_P: DB1.H51 (USB_HS_D_P), J6.3 (D+)
GNDD: C1.2, C2.2, C3.2, C4.2, C6.2, C7.2, C8.2, C9.2, C11.2, C12.2, C13.2, C14.2, C15.2, C16.2, C17.2, C18.2, C19.2, C20.2, C21.2, C22.2, C23.2, C24.2, C25.2, C26.2, C27.2, C28.2, C29.2, C30.2, C31.2, C32.2, C33.2, C34.2, C35.2, C37.2, C40.2, C44.2, C45.2, C46.2, C47.2, C48.2, C49.2, C50.2, C51.2, C52.2, C53.2, C54.2, C55.2, C56.2, C57.2, C58.2, C59.2, CON1.2, CON1.3, D1.1 (K), DB1.H6 (GND), DB1.H12 (GND), DB1.H13 (GND), DB1.H18 (GND), DB1.H19 (GND), DB1.H24 (GND), DB1.H25 (GND), DB1.H30 (GND), DB1.H31 (GND), DB1.H37 (GND), DB1.H40 (GND), DB1.H43 (GND), DB1.H46 (GND), DB1.H49 (GND), DB1.H52 (GND), DB1.H55 (GND), DB1.H58 (GND), DB1.L1 (GND), DB1.L2 (GND), DB1.L39 (GND), DB1.L40 (GND), J1.1, J2.1, J3.2, J3.5, J3.8, J3.11, J3.15, J3.16, J3.18, J3.19, J3.20, J3.21, J3.31, J3.32, J3.33, J3.34, J4.1, J4.3, J4.5, J5.1, J5.3, J5.5, J6.4 (GND), J6.5 (Shield), J7.3, J8.3, R2.1, R6.1, R10.1, R12.1, R18.1, R20.1, R22.1, R25.1, R33.1, R35.1, R37.1, R39.1, SW1.1, SW1.2, SW2.3, SW2.4, SW3.3, SW3.4, U1.4 (GND), U2.3 (GND), U4.5 (GND), U4.9 (EPAD), U5.5 (GND), U5.9 (EPAD), U6.2 (GND), U7.23 (GND), U7.26 (GND), U7.52 (GND), U7.64 (GND), U7.65 (PAD), U8.3 (GND), U9.3 (GND), U10.3 (GND), U11.5 (GND), U11.10 (GND), U12.7 (GND), U12.8 (GND), U13.7 (GND), U13.8 (GND), X1.2 (case), X1.4
REFCLK: C53.1, R45.1, U7.51 (REFCLK)
SENSOR_INT_L: DB1.L23 (GPIO_36/GPIO_A/APQ_INT), J7.6, R55.1
VCC: C8.1, C28.1, C30.1, C32.1, C34.1, R27.1, U7.17 (VCC), U7.33 (VCC), U7.49 (VCC), U7.59 (VCC), U7.62 (VCC)
VCCA: C29.1, C31.1, C33.1, C35.1, C37.1, C40.1, C56.1, C57.1, C58.1, R28.1, U7.3 (VCCA), U7.14 (VCCA), U7.18 (VCCA), U7.31 (VCCA), U7.36 (VCCA), U7.41 (VCCA), U7.43 (VCCA), U7.48 (VCCA)
VCCIO: C20.1, C21.1, C23.1, R23.1, R26.1, U7.53 (VCCIO), U7.63 (VCCIO)

Notes on the sheet:
Vout = Vref(1+R1/R2) Vout = 0.8(1+12.4/10) Vout = 1.792
Vout = Vref(1+R1/R2) Vout = 0.8(1+4.99/10) Vout = 1.1992

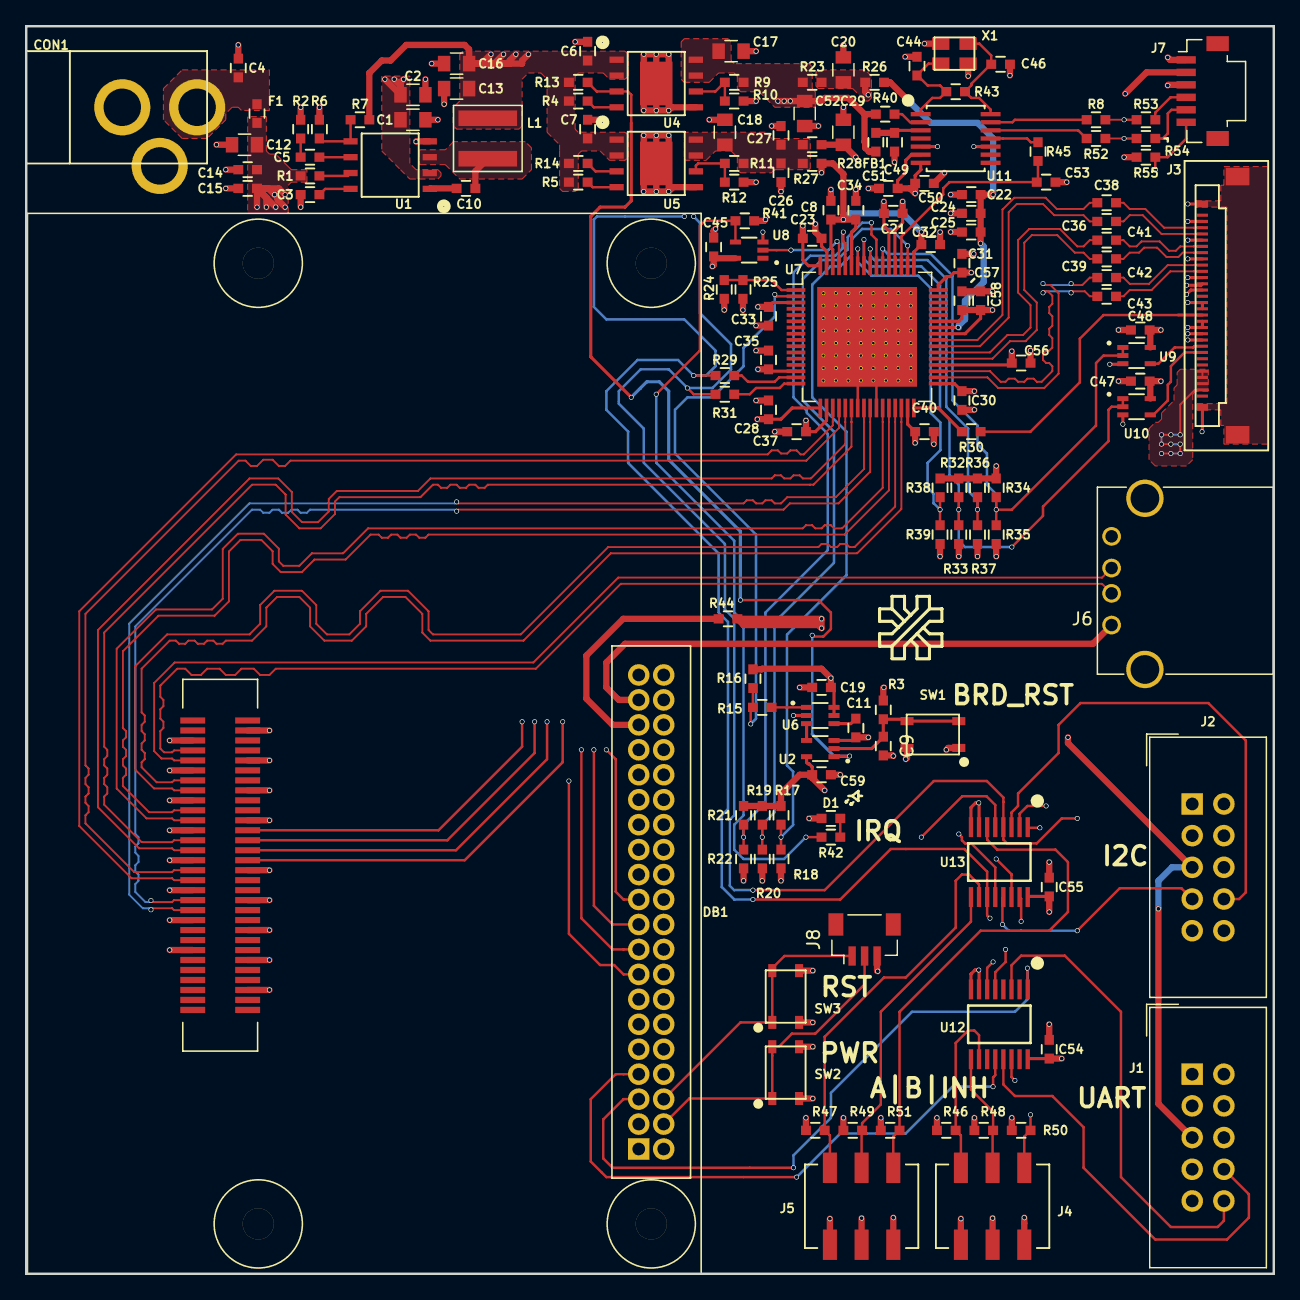
[picture p18: board Slate_Logic_Board.kicad_pcb from above]

Board: 4 copper layers, 100.0 x 100.0 mm, 144 parts (1 on the bottom side), 106 nets.
